AdrianCobo/my_bot/Bill.md

- [CAMARA OFICIAL 8MPX V2 PARA RASPBERRY PI (27.95)€](https://www.tiendatec.es/raspberry-pi/camaras/236-camara-oficial-8mpx-v2-para-raspberry-pi-652508442112.html)

- [RASPBERRY PI 4 - MODELO B - 4GB (78.95€)](https://www.tiendatec.es/raspberry-pi/gama-raspberry-pi/1100-raspberry-pi-4-modelo-b-4gb-765756931182.html)

- [DISIPADOR INTEGRAL CON VENTILADOR CONTROLADO POR SOFTWARE - PWM(9.95 €)](https://www.tiendatec.es/raspberry-pi/accesorios/1980-disipador-integral-con-ventilador-controlado-por-software-pwm-8472496024945.html)

- Gastos de envio de lo anterior(3.95€)

- [Micro-ssd 64GB(10€)](https://www.elcorteingles.es/search/?s=microssd&hierarchy=&deep_search=&stype=text_box)

- Cable usb a usbc (3.9€): Alcampo

- Cable HDMI a micro-usb(9.77€): Alcampo

- [Slamtec RPLIDAR A1 2D 360 grados 12 metros(119.99€)](https://www.amazon.es/Slamtec-RPLIDAR-esc%C3%A1ner-bst%C3%A1culos-navegaci%C3%B3n/dp/B07TJW5SXF)

- [ZOP POWER 11.1V 2700mAh 30C 3S LiPo Battery XT60 Plug(20.24€ + ShippingFee:7.96€ = 28.60)](https://usa.banggood.com/ZOP-POWER-11_1V-2700mAh-30C-3S-LiPo-Battery-XT60-Plug-for-RC-Drone-p-1984639.html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)

- [Multimeter AC/DC Votage Current...(9.19€)](https://usa.banggood.com/ANENG-SZ302-Digital-Multimeter-AC-or-DC-Votage-Current-Automatic-Tester-NCV-Detector-Resistance-Ohm-Ammeter-Capacitance-Meter-p-1975571.html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)

- [80W 6A Lipo Battery Balance Charger with Power Supply Adapter(25.52€)](https://usa.banggood.com/index.php?com=account&t=ordersDetail&ordersId=112329387&version=2&status=0)

- [Conectores de bala XT60 XT-60 macho y hembra, cable de silicona de 14 AWG (1.48€)](https://es.aliexpress.com/item/1005003658392996.html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)

- [Pin JST enchufe conector (1.76€)](https://es.aliexpress.com/item/1005005334563700.html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)

- [Caja de fusibles impermeable para coche, portafusibles estándar(2.11€)](https://es.aliexpress.com/item/1005003617756967.html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)

- [Lote de 10 conectores macho y hembra Jack 12V(0.99€)](https://es.aliexpress.com/item/1005004369381250.html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)

- [Interruptor basculante KCD1, interruptor de encendido de 3 pines con luz... (0.72€)](https://es.aliexpress.com/item/32957731774.html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)

- [Arduino uno (29.28€)](https://www.amazon.es/Arduino-UNO-A000066-microcontrolador-ATmega328/dp/B008GRTSV6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)

- [Controlador L298N Motores DC PAP Driver Stepper Doble puente H (3.99€)](https://www.amazon.es/gp/product/B07YNR5KWP/ref=ppx_od_dt_b_asin_title_s00?ie=UTF8&psc=1)

- [Cable Eléctrico 18 AWG (7,99€)](https://www.amazon.es/gp/product/B075M4VJ8J/ref=ppx_od_dt_b_asin_title_s01?ie=UTF8&psc=1)

- [2x DC 12V DIY Encoder Motorreductor Con Soporte de Montaje (24.74€)](https://www.amazon.es/gp/product/B07WT22RNJ/ref=ppx_od_dt_b_asin_title_s00?ie=UTF8&psc=1)

- [Hub USB 3.0 Alimentado (22.99€)](https://www.amazon.es/gp/product/B0BCPB7HQX/ref=ppx_od_dt_b_asin_title_s00?ie=UTF8&psc=1)

- [20Pcs Bloques de Terminales Eléctricos Regleta Electrica (14.99€)](https://www.amazon.es/gp/product/B092RZR3LX/ref=ppx_od_dt_b_asin_title_s00?ie=UTF8&psc=1)

- Gastos de envio de los 4 ultimos productos(3.29€), descuento de (-3.99€) e impuestos(17.26€)

- [df-dfr0205 convertidor Step Down (21,27€)](https://www.amazon.es/gp/product/B07FS7SLCB/ref=ppx_od_dt_b_asin_title_s00?ie=UTF8&psc=1)

- cable tie 50u (1,29€): Alcampo

- Caster Wheel (2,5€): Alcampo

- [Cable conector adaptador macho/hembra XT60 a Deans](https://es.aliexpress.com/item/1005004078144897.html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)

- [DC Conector Jack Clavija Convertidor 5,5 x 2,1 mm DC En Línea Enchufe a 3,5 mm x 1.3mm (2.47€)](https://www.amazon.es/dp/B00L36634W?psc=1&smid=A2X1ST6CC1USDW&ref_=chk_typ_imgToDp)

- Pilas AA para multimetro x8U (1.59€)

- [bolsa de batería Lipo, bolsa de protección de seguridad ignífuga (10.99€)](https://www.amazon.es/Kinsinder-protecci%C3%B3n-seguridad-resistente-explosiones/dp/B0BMLNRTBQ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)

-  [Lipo Battery Tester Monitor de bajo Voltaje Timbre Alarma Comprobador de Voltaje con indicador LED (7.49€)](https://www.amazon.es/QC-Battery-Monitor-Zumbador-indicador/dp/B077Z1N9CS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)

Total actual: 499.66€
