AdrianCobo/my_bot/doc/my_bot_diagram.png

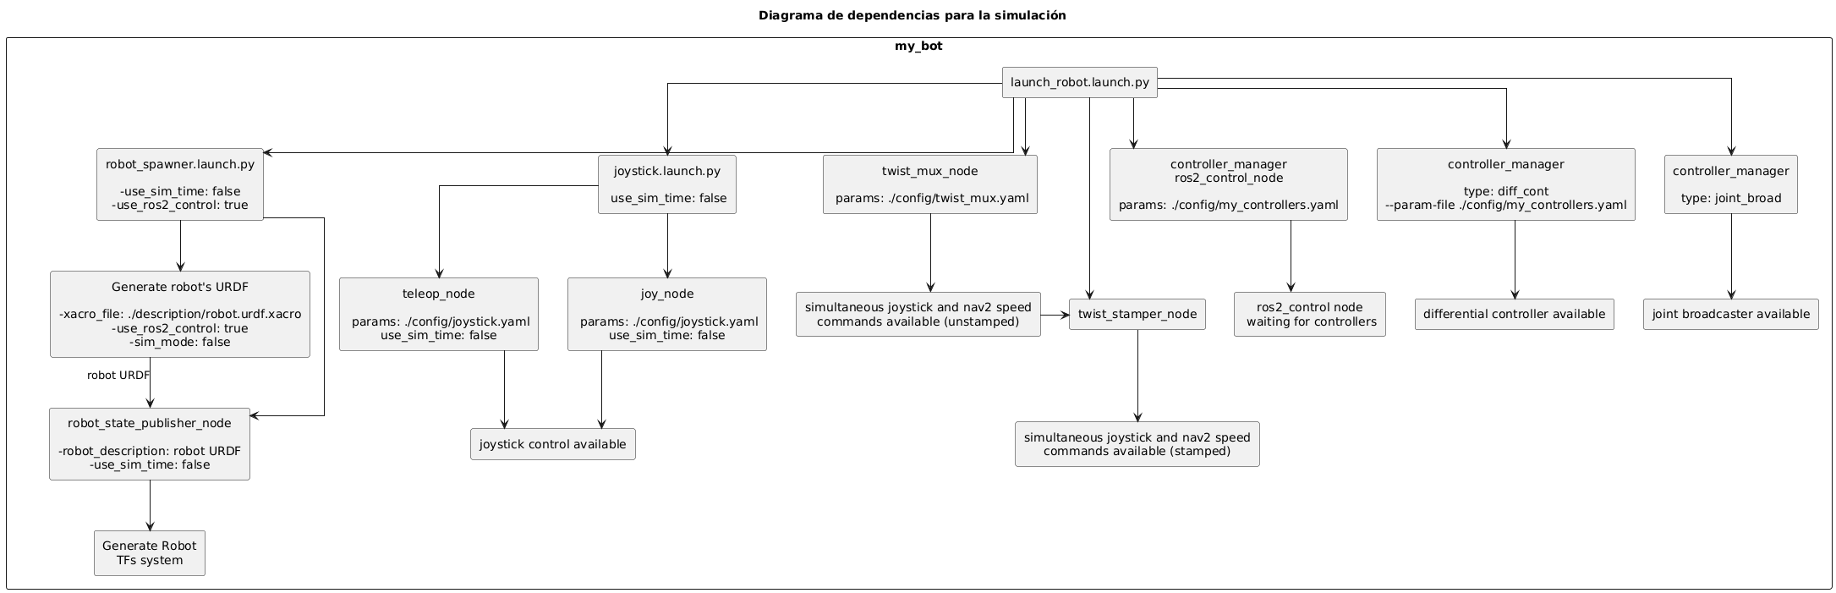
doc/my_bot_diagram.png
