AdrianCobo/my_bot/doc/my_bot_sym_diagram.png

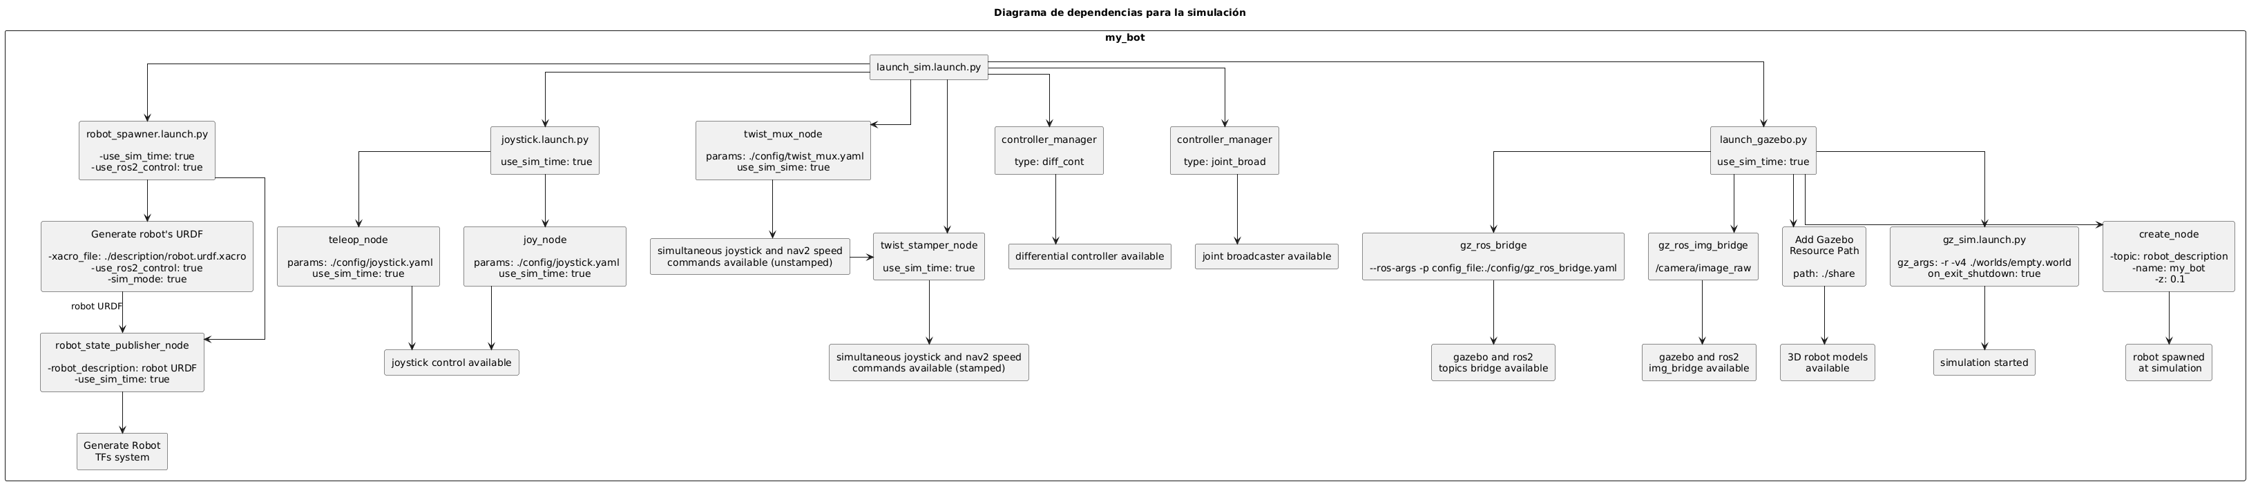
doc/my_bot_sym_diagram.png
