AdrianCobo/my_bot/meshes/caster_wheel/caster_wheel.stl

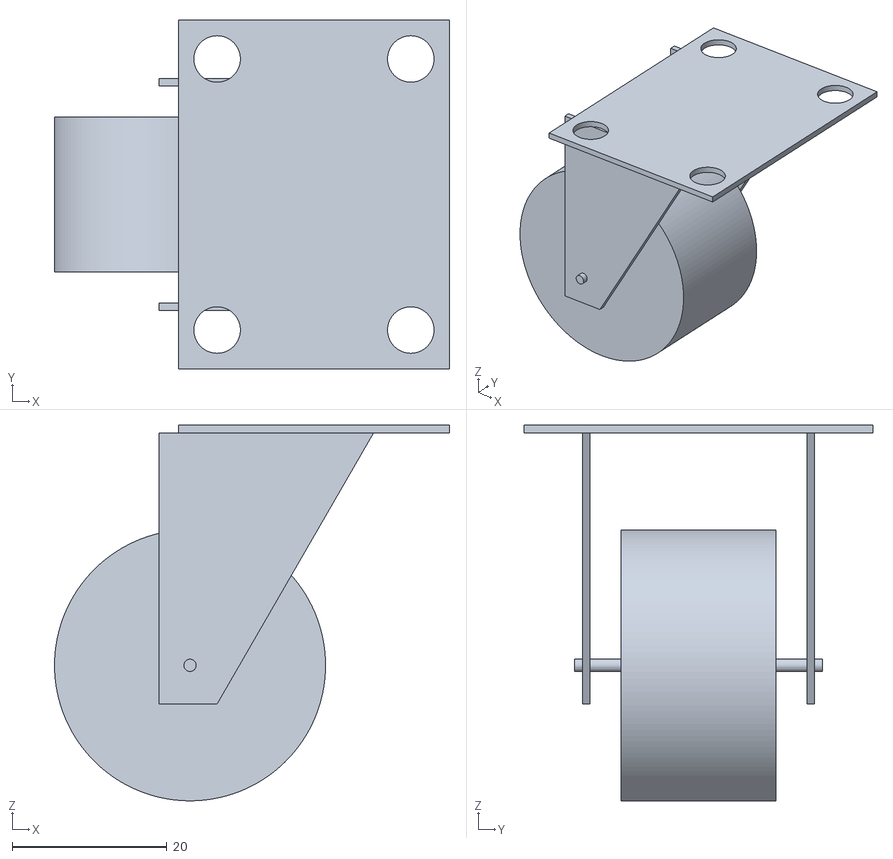
[picture p11: CAD file, 2024-05-24]
meshes/caster_wheel/caster_wheel.stl
51.0 x 45.0 x 48.5
