AdrianCobo/my_bot/meshes/lidar_a1/rplidar.stl

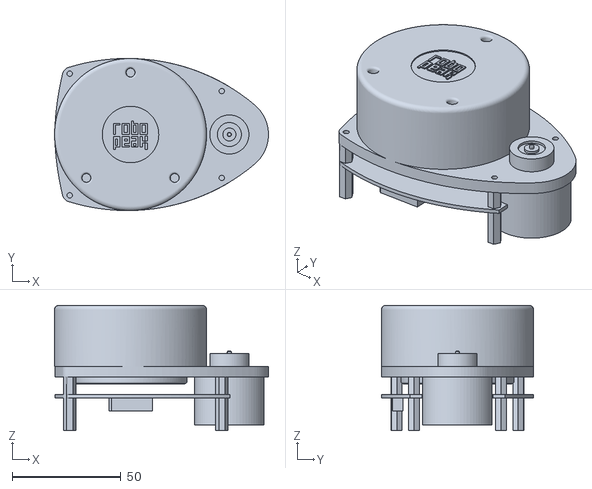
[picture p12: CAD file, 2024-05-31]
meshes/lidar_a1/rplidar.stl
98.5 x 70.0 x 57.7
