AdrianCobo/my_bot/(commit log)

2023-06-19 core urdf done
    [inertial_macros.xacro, robot.urdf.xacro, robot_core.xacro]
2023-06-19 wheels controler finished
    [gazebo_control.xacro, robot.urdf.xacro, robot_core.xacro]
2023-06-21 camera added
    [camera.xacro, lidar.xacro, robot.urdf.xacro]
2023-06-24 depth camera and ros2_controll config added
    [depth_camera.xacro, lidar.xacro, my_controllers.yaml, robot.urdf.xacro, ros2_control.xacro]
2023-06-27 slam_toolbox configured
    [robot_core.xacro]
2023-07-03 minor changes
    [depth_camera.xacro, lidar.xacro]
2023-07-05 a1 lidar launcher
2023-07-22 factura v1.2
    [model-1_2.sdf, model-1_3.sdf, model-1_4.sdf, model.sdf, r200_bracket.stl, r200_bracket_end.stl]
2023-08-18 testing encoders
    [ros2_control.xacro]
2023-08-18 salva lipos añadido
2023-08-19 camera launcher
    [real_robot.urdf.xacro, ros2_control.xacro]
2023-08-19 laser y camera xacro changed
    [camera.xacro, lidar.xacro, real_robot.urdf.xacro]
2023-08-20 REAL robot readme updated
    [camera.xacro]
2023-08-23 chassis changed
    [real_robot_core.xacro]
2023-11-14 Inicio del modelado 3D del bot: chasis
    [Bot_3DModel.FCStd]
2023-11-14 Modelo 3D: Ruedas traseras
    [Bot_3DModel.FCStd]
2023-11-14 Modelo 3D: Caster Wheel diseñada
    [Bot_3DModel.FCStd]
2023-11-14 Modelo 3D: Caster Wheel escalada
    [Bot_3DModel.FCStd]
2023-11-14 Modelo 3D: Switch
    [Bot_3DModel.FCStd]
2023-11-14 Modelo 3D: Camara incorporada
    [Bot_3DModel.FCStd]
2023-11-14 Modelo 3D: Soporte para LIDAR
    [Bot_3DModel.FCStd]
2023-11-14 Modelo 3D: Incorporacion de modelo LIDAR
    [Bot_3DModel.FCStd]
2023-11-14 Modelo 3D V1.0 Acabado
    [Bot_3DModel.FCStd]
2023-11-19 Subido circuito actualizado
2023-11-27 Circuito actualizado
2023-11-27 Update README.md
    real connection circuit added
2023-11-27 Revert "Circuit"
2023-11-27 Cables corregidos
2023-11-28 Tapa para chasis creada
    [Model3D_Imprimir.FCStd]
2023-11-28 Creado animacion de circuito
2023-11-30 Nuevo modelo 3D
    [Bot_3DModel.FCStd, Model3D_Imprimir.FCStd]
2023-12-04 Diseño 3D con taladros
    [Model3D_Imprimir.FCStd]
2023-12-04 Modelo 3D sin Taladros
    [Model3D_Imprimir_Sin_Taladros.FCStd, Model3D_Imprimir_Taladros.FCStd]
2023-12-04 Modelo 3D sin Taladros arreglos
    [Model3D_Imprimir_Sin_Taladros.FCStd]
2023-12-04 Exportacion de modelo en formato para impresora
    [Chasis.stl, Cilindro.stl, Tapa.stl]
2023-12-05 Modelo 3D segmentado
    [Chasis.stl, Cilindro.stl, Model3D_Imprimir_Sin_Taladros.FCStd, Tapa.stl]
2023-12-05 Exportacion de formato para impresora 3D
    [SegmentacionPiezas.stl]
2023-12-06 Animaciones creadas
    [Bot_3DModel.FCStd, Model3D_Imprimir_Sin_Taladros.FCStd, Model3D_Imprimir_Taladros.FCStd, SegmentacionPiezas.stl, bisagra.stl, camara.stl, chasis.stl, enganche.stl]
2023-12-06 Prueba de adicion de video a informe
2023-12-10 Modelos para imprimir
    [base.stl, cilindro.stl, enganche.stl, enganche_tapa.stl, frontal.stl, lateral.stl, tapa_cilindro.stl, tapa_hueca.stl]
2024-05-24 caster_wheel added
    [camera.xacro, caster_wheel.stl, lidar.xacro, real_robot_core.xacro, testing_freecad.stl, testing_freecad_color_blue.stl, testing_freecad_color_bluetesting_freecad_color_001.stl]
2024-05-24 xacro updated
    [real_robot_core.xacro, rplidar_main.STL]
2024-05-24 lidar model and caster wheel model added. Needs to solve problem with color and rviz
    [real_robot_core.xacro, rplidar_main.STL, rplidar_main.stl]
2024-05-24 odometri debuged
    [gazebo_control.xacro, lidar.xacro, my_controllers.yaml, real_robot_core.xacro]
2024-05-27 lidar launcher updated
2024-05-28 chassis link corrected
    [real_robot_core.xacro]
2024-05-30 gazebo and rviz mesh problem solved
    [real_robot_core.xacro]
2024-05-30 .dae is better
    [real_robot_core.xacro, testing_freecad.stl, testing_freecad_color_blue.stl, testing_freecad_color_bluetesting_freecad_color_001.stl]
2024-05-31 caster wheel color
    [real_robot_core.xacro, rplidar.stl, rplidar_main.stl, testing_freecad.stl]
2025-06-26 jazzy update
    [camera.xacro, gazebo_control.xacro, lidar.xacro, my_controllers.yaml, real_robot_core.xacro, robot.urdf.xacro, ros2_control.xacro]
2025-06-30 real_robot works
    [my_controllers.yaml, ros2_control.xacro]
